icepaka89/nixie-clock/Divergence Clock Bill Of Materials.xlsx

Part # | Manufacturer | Component | Package | Quantity | ORDER
LTV-852 | LITEON | Optocoupler | PDIP4 | 6 | YES
ATMEGA16A-AU | Atmel | 16-bit MCU | TQFP-44 | 1 | YES
ATTINY85-20SU | Atmel | 8-bit MCU | SOIC-8 | 2 | YES
K155ID1 | MSI | BCD To Decimal High Voltage Driver | PDIP16 | 1 | OWN
NH-14 | CCCP | Nixie Tube Gas Discharge Indicator | Through-Hole | 6 | OWN
- | - | RGB LED | Through-Hole | 5 | OWN
a12081600ux0477 | Uxcell | 12mm Piezoelectric Buzzer | Through-Hole | 1 | YES
EG1701-ND | E-Switch | 5501 Tactile Switch | Through-Hole | 3 | YES
- | Uxcell | 0.1uF Ceramic Disk Capacitor | Through-Hole | 1 | OWN
CR1206-JW-102GLFCT-ND | Bourns, Inc. | 1K Ohm RESISTOR | 1206 SMT | 6 | YES
RC1206FR-07316RL | Yageo | 316 Ohm RESISTOR | 1206 SMT | 6 | YES
311-64.9KFRCT-ND | Yageo | 65K Ohm RESISTOR | 1206 SMT | 2 | YES
- | - | RESISTOR (PROTOTYPE VALS) | Through-Hole | 5 | OWN
UX60A-MB-5ST | HRS | Mini-USB Connector | SMD | 1 | YES
PCH-45X-825KLT | Coilcraft | Fixed Inductor 8.2mH | Through-Hole | 1 | NO
IRFB4410ZPBF | Infineon | N-Channel Power MOSFET HEXFET | TO-220AB | 1 | YES
C1210C105K5RAC | Kemet | 1.0uF Ceramic Capacitor | SMD | 1 | YES
1N4148FS-ND | ON Semi | DIODE | Through-Hole | 1 | YES
- | SparkFun | 5mm LED, BLUE | Through-Hole | 4 | NO
- | SparkFun | 10mm LED, RGB | Through-Hole | 5 | NO
L7805ABV | STMicroelec | Linear Voltage Regulator 5V | TO-220AB | 1 | YES
- | Uxcell | 2x3 Dual Row Straight Header | Through-Hole | 3 | OWN
