icepaka89/nixie-clock/schematics/BOOST_CONVERTER.asc

C1: cap; 1µ; Rser=20.3m Lser=0 mfg="KEMET" pn="C1210C105K5RAC" type="X7R"
D1: diode; 1N4148
L1: ind; 8.2m; Ipk=311m Rser=5.5556 Rpar=772.44K Cpar=0 mfg="Coilcraft" pn="PCH-45X-825"
M2: nmos; IRFB4410Z
R1: res; 620K
V1: voltage; 5
V2: voltage; PULSE(0 5 0 0.000000001 0.000000001 0.0001945 0.0002000)
Named nets: 0, OUT, PULSE, MOS
.tran 0 300ms 0
