icepaka89/nixie-clock/schematics/nixie_clock.sch

## EAGLE design schematics/nixie_clock.sch (2020-12-22)

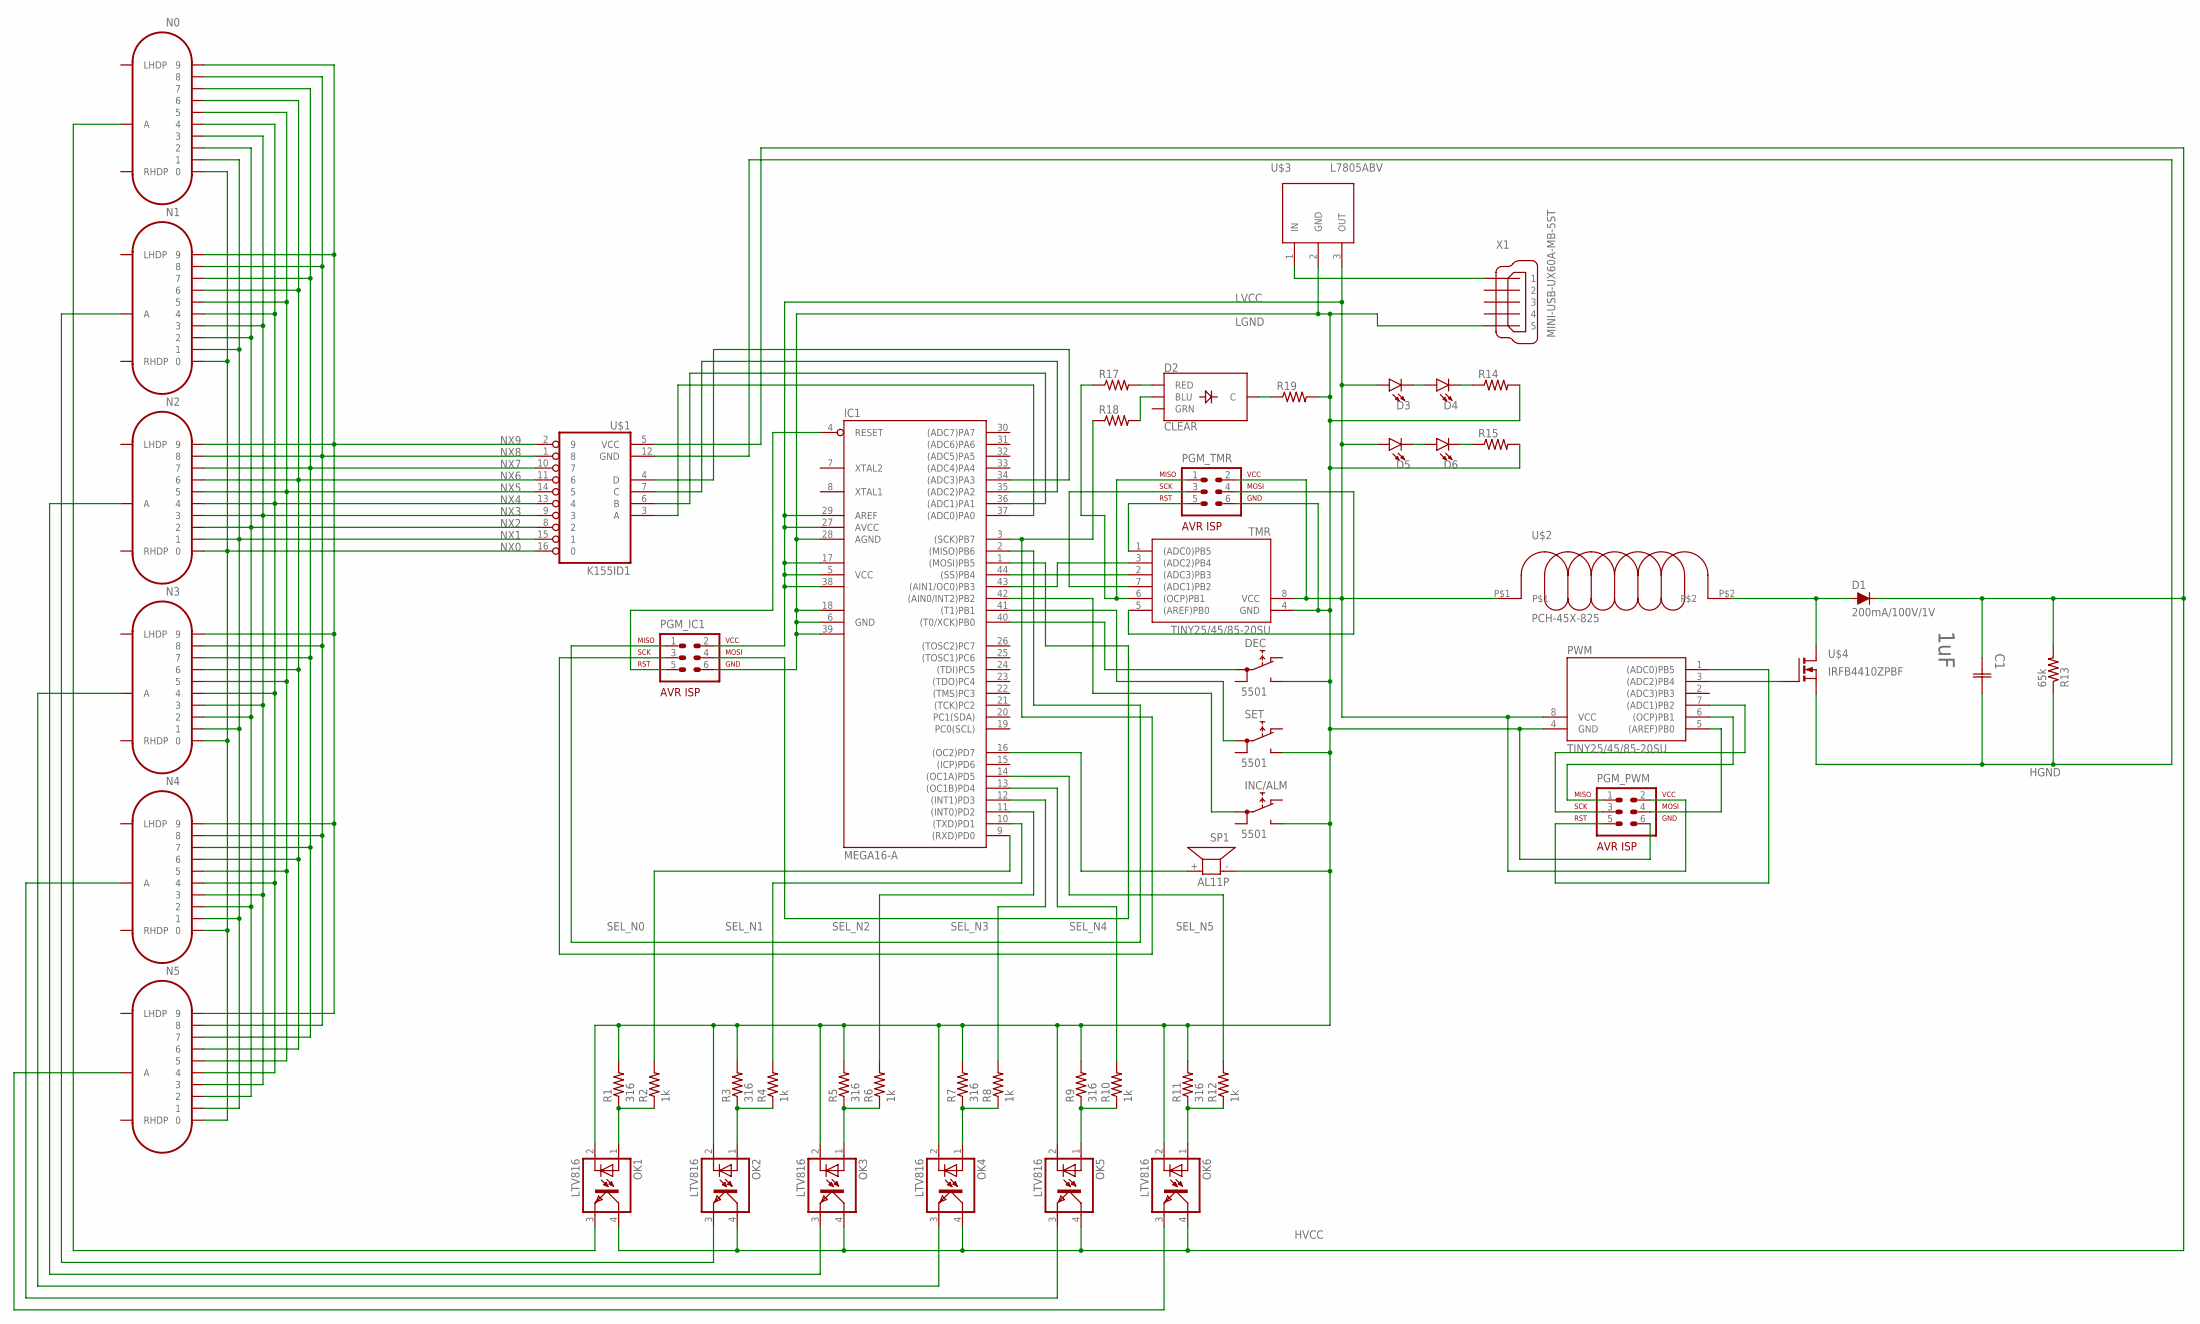
[picture p1: schematic nixie_clock.sch]

Parts:
C1: 1uF; CAPC3225X170N
D1: 200mA/100V/1V; DIODE-1N4148
D2: CLEAR; LED-RGB-THRU
D3, D4, D5, D6: LED5MM; LED_5MM
DEC: 5501
IC1: MEGA16-A; TQFP44
INC/ALM: 5501
N0, N1, N2, N3, N4, N5: IN-14
OK1, OK2, OK3, OK4, OK5, OK6: LTV816; DIL04
PGM_IC1: AVR-ISP-6HORZ; AVR-ISP-6R
PGM_PWM: AVR-ISP-6HORZ; AVR-ISP-6R
PGM_TMR: AVR-ISP-6HORZ; AVR-ISP-6R
PWM: TINY25/45/85-20SU; SOIC8
R1, R3, R5, R7, R9, R11: 316; M1206
R2, R4, R6, R8, R10, R12: 1k; M1206
R13: 65k; M1206
R14, R15, R17, R18, R19: R-US_0204/7; 0204/7
SET: 5501
SP1: AL11P
TMR: TINY25/45/85-20SU; SOIC8
U$1: K155ID1; DIL16
U$2: PCH-45X-825
U$3: L7805ABV; TO220AB
U$4: IRFB4410ZPBF; TO220AB
X1: MINI-USB-UX60A-MB-5ST; UX60A-MB-5ST

Connections:
HGND: C1.2 (C2), R13.1, U$1.12 (GND), U$4.3 (SG1)
HVCC: C1.1 (C1), D1.C, OK1.4 (COL), OK2.4 (COL), OK3.4 (COL), OK4.4 (COL), OK5.4 (COL), OK6.4 (COL), R13.2, U$1.5 (VCC)
LGND: DEC.NO, IC1.6 (GND), IC1.18 (GND1), IC1.28 (AGND), IC1.39 (GND2), INC/ALM.NO, OK1.2 (C), OK2.2 (C), OK3.2 (C), OK4.2 (C), OK5.2 (C), OK6.2 (C), PGM_IC1.6, PGM_PWM.6, PGM_TMR.6, PWM.4 (GND), R1.2, R3.2, R5.2, R7.2, R9.2, R11.2, R14.2, R15.2, R19.2, SET.NO, SP1.- (1), TMR.4 (GND), U$3.2 (GND), X1.5
LVCC: D3.A, D5.A, IC1.5 (VCC), IC1.17 (VCC1), IC1.27 (AVCC), IC1.29 (AREF), IC1.38 (VCC2), PGM_IC1.2, PGM_PWM.2, PGM_TMR.2, PWM.8 (VCC), TMR.8 (VCC), U$2.P$1, U$3.3 (OUT)
unnamed: IC1.37 ((ADC0)PA0), U$1.3 (A)
unnamed: IC1.36 ((ADC1)PA1), U$1.6 (B)
unnamed: IC1.35 ((ADC2)PA2), U$1.7 (C)
unnamed: IC1.34 ((ADC3)PA3), U$1.4 (D)
unnamed: PGM_TMR.3, TMR.7 ((ADC1)PB2)
unnamed: IC1.43 ((AIN1/OC0)PB3), TMR.3 ((ADC2)PB4)
unnamed: DEC.1A, IC1.40 ((T0/XCK)PB0)
unnamed: IC1.41 ((T1)PB1), SET.1A
unnamed: IC1.42 ((AIN0/INT2)PB2), INC/ALM.1A
unnamed: OK1.1 (A), R1.1, R2.1
unnamed: OK2.1 (A), R3.1, R4.1
unnamed: OK3.1 (A), R5.1, R6.1
unnamed: OK4.1 (A), R7.1, R8.1
unnamed: OK5.1 (A), R9.1, R10.1
unnamed: OK6.1 (A), R11.1, R12.1
unnamed: N0.A, OK1.3 (EMIT)
unnamed: N1.A, OK2.3 (EMIT)
unnamed: N2.A, OK3.3 (EMIT)
unnamed: N3.A, OK4.3 (EMIT)
unnamed: N4.A, OK5.3 (EMIT)
unnamed: N5.A, OK6.3 (EMIT)
unnamed: D1.A, U$2.P$2, U$4.2 (D)
unnamed: PWM.3 ((ADC2)PB4), U$4.1 (G)
unnamed: IC1.16 ((OC2)PD7), SP1.+ (2)
unnamed: D2.2 (C), R19.1
unnamed: D2.1 (RED), R17.2
unnamed: D2.4 (BLU), R18.2
unnamed: PGM_TMR.1, R17.1, TMR.6 ((OCP)PB1)
unnamed: IC1.3 ((SCK)PB7), PGM_IC1.3, R18.1
unnamed: PGM_TMR.4, TMR.5 ((AREF)PB0)
unnamed: IC1.44 ((SS)PB4), TMR.2 ((ADC3)PB3)
unnamed: PGM_PWM.1, PWM.6 ((OCP)PB1)
unnamed: PGM_TMR.5, TMR.1 ((ADC0)PB5)
unnamed: PGM_PWM.3, PWM.7 ((ADC1)PB2)
unnamed: PGM_PWM.5, PWM.1 ((ADC0)PB5)
unnamed: PGM_PWM.4, PWM.5 ((AREF)PB0)
unnamed: IC1.1 ((MOSI)PB5), PGM_IC1.4
unnamed: IC1.2 ((MISO)PB6), PGM_IC1.1
unnamed: U$3.1 (IN), X1.1
unnamed: IC1.4 (RESET), PGM_IC1.5
unnamed: D3.K (C), D4.A
unnamed: D4.K (C), R14.1
unnamed: D5.K (C), D6.A
unnamed: D6.K (C), R15.1
NX0: N0.0, N1.0, N2.0, N3.0, N4.0, N5.0, U$1.16 (0)
NX1: N0.1, N1.1, N2.1, N3.1, N4.1, N5.1, U$1.15 (1)
NX2: N0.2, N1.2, N2.2, N3.2, N4.2, N5.2, U$1.8 (2)
NX3: N0.3, N1.3, N2.3, N3.3, N4.3, N5.3, U$1.9 (3)
NX4: N0.4, N1.4, N2.4, N3.4, N4.4, N5.4, U$1.13 (4)
NX5: N0.5, N1.5, N2.5, N3.5, N4.5, N5.5, U$1.14 (5)
NX6: N0.6, N1.6, N2.6, N3.6, N4.6, N5.6, U$1.11 (6)
NX7: N0.7, N1.7, N2.7, N3.7, N4.7, N5.7, U$1.10 (7)
NX8: N0.8, N1.8, N2.8, N3.8, N4.8, N5.8, U$1.1 (8)
NX9: N0.9, N1.9, N2.9, N3.9, N4.9, N5.9, U$1.2 (9)
SEL_N0: IC1.9 ((RXD)PD0), R2.2
SEL_N1: IC1.10 ((TXD)PD1), R4.2
SEL_N2: IC1.11 ((INT0)PD2), R6.2
SEL_N3: IC1.12 ((INT1)PD3), R8.2
SEL_N4: IC1.13 ((OC1B)PD4), R10.2
SEL_N5: IC1.14 ((OC1A)PD5), R12.2
