icepaka89/nixie-clock/(notices)

Notices in the files:
parts and their libraries:
Discrete-Semi: Licensing: Creative Commons ShareAlike 4.0 International - https://creativecommons.org/licenses/by-sa/4.0
